fgsvftxv/FlexiTac-2/FlexiTac/Hardware/BOM_FlexiTac_Mini_v1_16x32.xlsx

Sheet: bom模板
 |  |  |  | Bill of Materials | BOM_FlexiTac_Mini_v1_16x32
 |  |  |  | Project Title： | FlexiTac
 |  |  |  | Variant:
 |  |  |  | Report Time： | 2026年7月24日 11:50:50
No. | Quantity | Comment | Designator | Footprint | Value | Manufacturer Part | Manufacturer | Supplier Part | Supplier | LCSC Price | Total
 | 1 | 0R | R1 | R0402 | 0R
 | 1 | 1uF | C7 | C0402 | 1uF
 | 1 | 4.7uF | C8 | C0402 | 4.7uF
 | 1 | 8MHz | X1 | OSC-SMD_3P-L3.2-W1.3-P1.20 | 8MHz | CSTNE8M00G520000R0 | muRata(村田) | C907975 | LCSC | 2.0502
 | 1 | 20R | R7 | R0402 | 20R
 | 1 | 47K | R2 | R0402 | 47K
 | 1 | AT32F415KBU7-4 | U6 | QFN-32_L4.0-W4.0-P0.40-BL-EP2.7 |  | AT32F415KBU7-4 | ARTERY(雅特力) | C528424 | LCSC | 8.42
 | 1 | CD74HC4067SM96 | U2 | SSOP-24_L8.1-W5.3-P0.65-LS7.8-BL |  | CD74HC4067SM96 | TI(德州仪器) | C98457 | LCSC | 3.53
 | 1 | HC-FPC-05-09-16RLTAG | CN1 | CONN-SMD_16P-P0.50_HCTL_HC-FPC-05-09-16RLTAG |  | HC-FPC-05-09-16RLTAG | HCTL(华灿天禄) | C5213753 | LCSC | 1.1019
 | 1 | HC-FPC-05-09-32RLTAG | CN2 | CONN-SMD_32P-P0.50_HCTL_HC-FPC-05-09-32RLTAG |  | HC-FPC-05-09-32RLTAG | HCTL(华灿天禄) | C5213761 | LCSC | 1.2977
 | 1 | LP5907MFX-3.3/NOPB | U3 | SOT-23-5_L3.0-W1.7-P0.95-LS2.8-BR |  | LP5907MFX-3.3/NOPB | TI(德州仪器) | C80670 | LCSC | 1.2647
 | 1 | POWER | LED1 | LED0805-R-RD |  | NCD0805R1 | 国星光电 | C84256 | LCSC | 0.082
 | 1 | SI2301 | Q1 | SOT-23-3_L2.9-W1.3-P1.90-LS2.4-BR |  | SI2301 | YONGYUTAI(永裕泰) | C2891731 | LCSC | 0.1185
 | 1 | STATUS | LED2 | LED0805-R-RD |  | NCD0805R1 | 国星光电 | C84256 | LCSC | 0.082
 | 1 | TLV75733PDBVR | U1 | SOT-23-5_L2.9-W1.6-P0.95-LS2.8-BL |  | TLV75733PDBVR | TI(德州仪器) | C485517 | LCSC | 1.1437
 | 1 | TYPE-C 16PIN 2MD(073) | USB1 | USB-C-SMD_TYPE-C-6PIN-2MD-073 |  | TYPE-C 16PIN 2MD(073) | SHOU HAN(首韩) | C2765186 | LCSC | 0.4563
 | 2 | 4.7K | R8, R9 | R0402 | 4.7K
 | 2 | 5.1K | R13, R16 | R0402 | 5.1K
 | 2 | 10K | R3, R4 | R0402 | 10K
 | 2 | 20K | R5, R6 | R0402 | 20K
 | 2 | SS8550 | Q2, Q3 | SOT-23-3_L2.9-W1.3-P1.90-LS2.4-BR |  | SS8550 | R+O(宏嘉诚) | C7420371 | LCSC | 0.0858
 | 2 | WAFER-GH1.25-4PWB | U9, U10 | CONN-SMD_4P-P1.25_XUNPU_WAFER-GH1.25-4PWB |  | WAFER-GH1.25-4PWB | XUNPU(讯普) | C3029379 | LCSC | 0.759
 | 4 | SN74HC595PWR | U4, U5, U7, U8 | TSSOP-16_L5.0-W4.4-P0.65-LS6.4-BL |  | SN74HC595PWR | TI(德州仪器) | C273642 | LCSC | 1.1074
 | 5 | 10uF | C1, C2, C5, C17, C18 | C0402 | 10uF
 | 6 | 2.2R | R11, R12, R14, R15, R17, R18 | R0402 | 2.2R
 | 8 | 100nF | C6, C9, C10, C11, C12, C14, C15, C16 | C0402 | 100nF

Sheet: Field汇总
Project Title | FlexiTac
Borard Title | Reading_Board_16x32
Schematic Title | Schematic1
PCB Title | PCB1
Variant Name
Total Quantity | 51
Report Time | 11:50:50
Report Date | 2026年7月24日
Report Date&Time | 2026年7月24日 11:50:50
File Name | BOM_FlexiTac_Mini_v1_16x32
Filter Option | Add into BOM:no; Convert to PCB:no;
