fgsvftxv/FlexiTac-2/FlexiTac/Hardware/SCH_FlexiTac_Mini_v1_16x32.pdf

10 10 11 11 12 12 13 13 14 14 15 15 16 16

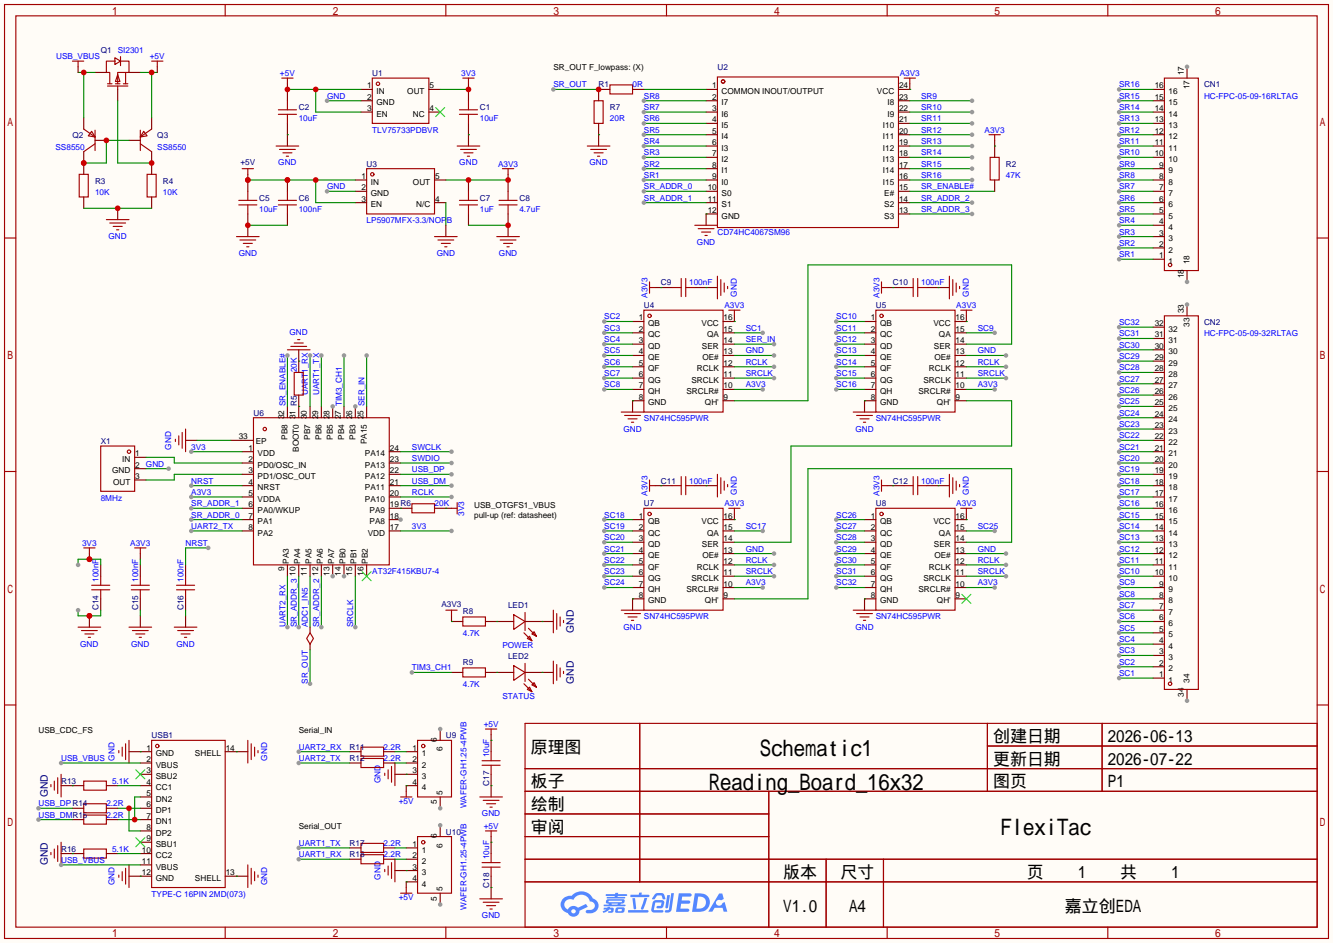
[picture p4: page 1]

SRCLR# 10 SRCLK 11 RCLK 12 OE# 13 SER 14 QA 15 VCC 16

USB_OTGFS1_VBUS
pull-up (ref: datasheet)

原理图 | Schematic1 | 创建日期 | 2026-06-13
板子 | Reading_Board_16x32 | 图页 | P1
绘制 | | FlexiTac
审阅

更新日期 | 2026-07-22

V1.0 | A4 | 嘉立创EDA
