fgsvftxv/FlexiTac-2/FlexiTac/Firmware/FlexiTac_16x32/project/src/main.c

/* add user code begin Header */
/**
  **************************************************************************
  * @file     main.c
  * @brief    main program
  **************************************************************************
  * Copyright (c) 2025, Artery Technology, All rights reserved.
  *
  * The software Board Support Package (BSP) that is made available to
  * download from Artery official website is the copyrighted work of Artery.
  * Artery authorizes customers to use, copy, and distribute the BSP
  * software and its related documentation for the purpose of design and
  * development in conjunction with Artery microcontrollers. Use of the
  * software is governed by this copyright notice and the following disclaimer.
  *
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
  **************************************************************************
  */
/* add user code end Header */

/* Includes ------------------------------------------------------------------*/
#include "at32f415_wk_config.h"
#include "wk_adc.h"
#include "wk_debug.h"
#include "wk_tmr.h"
#include "wk_usart.h"
#include "wk_usb_otgfs.h"
#include "wk_dma.h"
#include "wk_gpio.h"
#include "usb_app.h"
#include "wk_system.h"

/* private includes ----------------------------------------------------------*/
/* add user code begin private includes */
#include "global_include.h"
/* add user code end private includes */

/* private typedef -----------------------------------------------------------*/
/* add user code begin private typedef */

/* add user code end private typedef */

/* private define ------------------------------------------------------------*/
/* add user code begin private define */

/* add user code end private define */

/* private macro -------------------------------------------------------------*/
/* add user code begin private macro */

/* add user code end private macro */

/* private variables ---------------------------------------------------------*/
/* add user code begin private variables */

/* add user code end private variables */

/* private function prototypes --------------------------------------------*/
/* add user code begin function prototypes */

/* add user code end function prototypes */

/* private user code ---------------------------------------------------------*/
/* add user code begin 0 */
#define wk_usb_app_task() ;
#define wk_dma1_channel1_init() ;
#define wk_dma_channel_config(a, b, c, d) ;
#define dma_channel_enable(a, b) ;
#define wk_adc1_init() ;
/* add user code end 0 */

/**
  * @brief main function.
  * @param  none
  * @retval none
  */
int main(void)
{
  /* add user code begin 1 */

  /* add user code end 1 */

  /* system clock config. */
  wk_system_clock_config();

  /* config periph clock. */
  wk_periph_clock_config();

  /* init debug function. */
  wk_debug_config();

  /**
   * users need add interrupt handler code into the below function in the at32f415_int.c file.
   *  --void SystTick_IRQHandler(void)
   */
  systick_interrupt_config(1000);

  /* nvic config. */
  wk_nvic_config();

  /* timebase config for
     void wk_delay_us(uint32_t delay);
     void wk_delay_ms(uint32_t delay); */
  wk_timebase_init();

  /* init gpio function. */
  wk_gpio_config();

  /* init adc1 function. */
  wk_adc1_init();

  /* init usart1 function. */
  wk_usart1_init();

  /* init usart2 function. */
  wk_usart2_init();

  /* init tmr3 function. */
  wk_tmr3_init();

  /* init usb_otgfs1 function. */
  wk_usb_otgfs1_init();

  /* init usb app function. */
  wk_usb_app_init();

  /* init dma1 channel1 */
  wk_dma1_channel1_init();
  /* config dma channel transfer parameter */
  /* user need to modify define values DMAx_CHANNELy_XXX_BASE_ADDR 
     and DMAx_CHANNELy_BUFFER_SIZE in at32xxx_wk_config.h */
  wk_dma_channel_config(DMA1_CHANNEL1, 
                        (uint32_t)&USART1->dt, 
                        DMA1_CHANNEL1_MEMORY_BASE_ADDR, 
                        DMA1_CHANNEL1_BUFFER_SIZE);
  dma_channel_enable(DMA1_CHANNEL1, TRUE);

  /* init dma1 channel2 */
  wk_dma1_channel2_init();
  /* config dma channel transfer parameter */
  /* user need to modify define values DMAx_CHANNELy_XXX_BASE_ADDR 
     and DMAx_CHANNELy_BUFFER_SIZE in at32xxx_wk_config.h */
  wk_dma_channel_config(DMA1_CHANNEL2, 
                        (uint32_t)&USART1->dt, 
                        DMA1_CHANNEL2_MEMORY_BASE_ADDR, 
                        DMA1_CHANNEL2_BUFFER_SIZE);
  dma_channel_enable(DMA1_CHANNEL2, TRUE);

  /* init dma1 channel3 */
  wk_dma1_channel3_init();
  /* config dma channel transfer parameter */
  /* user need to modify define values DMAx_CHANNELy_XXX_BASE_ADDR 
     and DMAx_CHANNELy_BUFFER_SIZE in at32xxx_wk_config.h */
  wk_dma_channel_config(DMA1_CHANNEL3, 
                        (uint32_t)&USART2->dt, 
                        DMA1_CHANNEL3_MEMORY_BASE_ADDR, 
                        DMA1_CHANNEL3_BUFFER_SIZE);
  dma_channel_enable(DMA1_CHANNEL3, TRUE);

  /* init dma1 channel4 */
  wk_dma1_channel4_init();
  /* config dma channel transfer parameter */
  /* user need to modify define values DMAx_CHANNELy_XXX_BASE_ADDR 
     and DMAx_CHANNELy_BUFFER_SIZE in at32xxx_wk_config.h */
  wk_dma_channel_config(DMA1_CHANNEL4, 
                        (uint32_t)&USART2->dt, 
                        DMA1_CHANNEL4_MEMORY_BASE_ADDR, 
                        DMA1_CHANNEL4_BUFFER_SIZE);
  dma_channel_enable(DMA1_CHANNEL4, TRUE);

  /* add user code begin 2 */
  app_init();
  /* add user code end 2 */

  while(1)
  {
    wk_usb_app_task();

    /* add user code begin 3 */
    app_loop();
    /* add user code end 3 */
  }
}

  /* add user code begin 4 */

  /* add user code end 4 */
