fgsvftxv/FlexiTac-2/FlexiTac/Firmware/FlexiTac_16x32/project/inc/at32f415_wk_config.h

/* add user code begin Header */
/**
  **************************************************************************
  * @file     at32f415_wk_config.h
  * @brief    header file of work bench config
  **************************************************************************
  * Copyright (c) 2025, Artery Technology, All rights reserved.
  *
  * The software Board Support Package (BSP) that is made available to
  * download from Artery official website is the copyrighted work of Artery.
  * Artery authorizes customers to use, copy, and distribute the BSP
  * software and its related documentation for the purpose of design and
  * development in conjunction with Artery microcontrollers. Use of the
  * software is governed by this copyright notice and the following disclaimer.
  *
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
  **************************************************************************
  */
/* add user code end Header */

/* define to prevent recursive inclusion -----------------------------------*/
#ifndef __AT32F415_WK_CONFIG_H
#define __AT32F415_WK_CONFIG_H

#ifdef __cplusplus
extern "C" {
#endif

/* includes -----------------------------------------------------------------------*/
#include "stdio.h"
#include "at32f415.h"

/* private includes -------------------------------------------------------------*/
/* add user code begin private includes */

/* add user code end private includes */

/* exported types -------------------------------------------------------------*/
/* add user code begin exported types */

/* add user code end exported types */

/* exported constants --------------------------------------------------------*/
/* add user code begin exported constants */

/* add user code end exported constants */

/* exported macro ------------------------------------------------------------*/
/* add user code begin exported macro */

/* add user code end exported macro */

/* add user code begin dma define */
/* user can only modify the dma define value */
#define DMA1_CHANNEL1_BUFFER_SIZE   0
#define DMA1_CHANNEL1_MEMORY_BASE_ADDR   0
//#define DMA1_CHANNEL1_PERIPHERAL_BASE_ADDR  0

#define DMA1_CHANNEL2_BUFFER_SIZE   0
#define DMA1_CHANNEL2_MEMORY_BASE_ADDR   0
//#define DMA1_CHANNEL2_PERIPHERAL_BASE_ADDR   0

#define DMA1_CHANNEL3_BUFFER_SIZE   0
#define DMA1_CHANNEL3_MEMORY_BASE_ADDR   0
//#define DMA1_CHANNEL3_PERIPHERAL_BASE_ADDR   0

#define DMA1_CHANNEL4_BUFFER_SIZE   0
#define DMA1_CHANNEL4_MEMORY_BASE_ADDR   0
//#define DMA1_CHANNEL4_PERIPHERAL_BASE_ADDR   0

//#define DMA1_CHANNEL5_BUFFER_SIZE   0
//#define DMA1_CHANNEL5_MEMORY_BASE_ADDR   0
//#define DMA1_CHANNEL5_PERIPHERAL_BASE_ADDR   0

//#define DMA1_CHANNEL6_BUFFER_SIZE   0
//#define DMA1_CHANNEL6_MEMORY_BASE_ADDR   0
//#define DMA1_CHANNEL6_PERIPHERAL_BASE_ADDR   0

//#define DMA1_CHANNEL7_BUFFER_SIZE   0
//#define DMA1_CHANNEL7_MEMORY_BASE_ADDR   0
//#define DMA1_CHANNEL7_PERIPHERAL_BASE_ADDR   0

//#define DMA2_CHANNEL1_BUFFER_SIZE   0
//#define DMA2_CHANNEL1_MEMORY_BASE_ADDR   0
//#define DMA2_CHANNEL1_PERIPHERAL_BASE_ADDR   0

//#define DMA2_CHANNEL2_BUFFER_SIZE   0
//#define DMA2_CHANNEL2_MEMORY_BASE_ADDR   0
//#define DMA2_CHANNEL2_PERIPHERAL_BASE_ADDR   0

//#define DMA2_CHANNEL3_BUFFER_SIZE   0
//#define DMA2_CHANNEL3_MEMORY_BASE_ADDR   0
//#define DMA2_CHANNEL3_PERIPHERAL_BASE_ADDR   0

//#define DMA2_CHANNEL4_BUFFER_SIZE   0
//#define DMA2_CHANNEL4_MEMORY_BASE_ADDR   0
//#define DMA2_CHANNEL4_PERIPHERAL_BASE_ADDR   0

//#define DMA2_CHANNEL5_BUFFER_SIZE   0
//#define DMA2_CHANNEL5_MEMORY_BASE_ADDR   0
//#define DMA2_CHANNEL5_PERIPHERAL_BASE_ADDR   0

//#define DMA2_CHANNEL6_BUFFER_SIZE   0
//#define DMA2_CHANNEL6_MEMORY_BASE_ADDR   0
//#define DMA2_CHANNEL6_PERIPHERAL_BASE_ADDR   0

//#define DMA2_CHANNEL7_BUFFER_SIZE   0
//#define DMA2_CHANNEL7_MEMORY_BASE_ADDR   0
//#define DMA2_CHANNEL7_PERIPHERAL_BASE_ADDR   0
/* add user code end dma define */

/* Private defines -------------------------------------------------------------*/
#define SR_ADDR_1_PIN    GPIO_PINS_0
#define SR_ADDR_1_GPIO_PORT    GPIOA
#define SR_ADDR_0_PIN    GPIO_PINS_1
#define SR_ADDR_0_GPIO_PORT    GPIOA
#define SR_ADDR_3_PIN    GPIO_PINS_4
#define SR_ADDR_3_GPIO_PORT    GPIOA
#define SR_ADDR_2_PIN    GPIO_PINS_6
#define SR_ADDR_2_GPIO_PORT    GPIOA
#define SRCLK_PIN    GPIO_PINS_1
#define SRCLK_GPIO_PORT    GPIOB
#define RCLK_PIN    GPIO_PINS_10
#define RCLK_GPIO_PORT    GPIOA
#define SER_IN_PIN    GPIO_PINS_15
#define SER_IN_GPIO_PORT    GPIOA
#define SR_ENABLE_PIN    GPIO_PINS_8
#define SR_ENABLE_GPIO_PORT    GPIOB

/* exported functions ------------------------------------------------------- */
  /* system clock config. */
  void wk_system_clock_config(void);

  /* config periph clock. */
  void wk_periph_clock_config(void);

  /* nvic config. */
  void wk_nvic_config(void);

/* add user code begin exported functions */

/* add user code end exported functions */

#ifdef __cplusplus
}
#endif

#endif
