fgsvftxv/FlexiTac-2/FlexiTac/Firmware/FlexiTac_16x32/User/Apps/flexitac_packet.c

#include "flexitac_packet.h"

#include <string.h>

uint32_t get_serial_number(void)
{
#if defined(AT32F403Axx) || defined(AT32F407xx) || defined(AT32F435xx) || defined(AT32F415KBU7_4)
#define FLASH_SIZE_BASE 0x1FFFF7E0
#define UID_BASE_1      0x1FFFF7E8
#define UID_BASE_2      0x1FFFF7EC
#define UID_BASE_3      0x1FFFF7F0
    const uint8_t *p = (const uint8_t *)UID_BASE_1;
    return ((uint32_t)p[10]<<24) | ((uint32_t)p[1]<<8) | p[0]
        | (((p[9]&0x80)|((p[4]&0x03)<<5)|((p[3]&0xF0)>>3)|(p[2]&0x01))<<16);
#else
#warning "_get_sn() unavailable for unknown chip"
#endif
}

static uint8_t crc16_table_h[256] =
    {
            0x00, 0xC1, 0x81, 0x40, 0x01, 0xC0, 0x80, 0x41, 0x01, 0xC0, 0x80, 0x41,
            0x00, 0xC1, 0x81, 0x40, 0x01, 0xC0, 0x80, 0x41, 0x00, 0xC1, 0x81, 0x40,
            0x00, 0xC1, 0x81, 0x40, 0x01, 0xC0, 0x80, 0x41, 0x01, 0xC0, 0x80, 0x41,
            0x00, 0xC1, 0x81, 0x40, 0x00, 0xC1, 0x81, 0x40, 0x01, 0xC0, 0x80, 0x41,
            0x00, 0xC1, 0x81, 0x40, 0x01, 0xC0, 0x80, 0x41, 0x01, 0xC0, 0x80, 0x41,
            0x00, 0xC1, 0x81, 0x40, 0x01, 0xC0, 0x80, 0x41, 0x00, 0xC1, 0x81, 0x40,
            0x00, 0xC1, 0x81, 0x40, 0x01, 0xC0, 0x80, 0x41, 0x00, 0xC1, 0x81, 0x40,
            0x01, 0xC0, 0x80, 0x41, 0x01, 0xC0, 0x80, 0x41, 0x00, 0xC1, 0x81, 0x40,
            0x00, 0xC1, 0x81, 0x40, 0x01, 0xC0, 0x80, 0x41, 0x01, 0xC0, 0x80, 0x41,
            0x00, 0xC1, 0x81, 0x40, 0x01, 0xC0, 0x80, 0x41, 0x00, 0xC1, 0x81, 0x40,
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
/// Initial Value: 0xFFFF, Input Flip: Yes, Output Flip: No \n
/// XOR Value: 0x0000
/// \param data
/// \param len
/// \return
uint16_t get_crc16(const uint8_t* data, const size_t len)
{
    return get_crc16_accumulate(0xFFFF, data, len);
}

uint32_t serial_number = 0;
uint32_t tick_ms = 0;

uint8_t build_flexitac_packet(uint8_t* dst_buffer, uint16_t* dst_buffer_in_out_size, const uint16_t* sample_data, const uint16_t sample_count)
{
    if(!dst_buffer || !dst_buffer_in_out_size || !sample_data || *dst_buffer_in_out_size < sizeof(flexitac_packet_t)) return 0;
    flexitac_packet_t* packet = (flexitac_packet_t*)dst_buffer;
    if(sample_count != FLEXITAC_SAMPLE_COUNT) return 0;
    packet->ext_header_0x54 = 0x54;
    packet->ext_header_0xaa = 0xAA;
    if(!serial_number) serial_number = get_serial_number();
    packet->node_uuid_u16[0] = (uint8_t)(serial_number & 0xFF);
    packet->node_uuid_u16[1] = (uint8_t)(serial_number >> 8);
    packet->node_timestamp[0] = (uint8_t)(tick_ms & 0xFF);
    packet->node_timestamp[1] = (uint8_t)(tick_ms >> 8);
    packet->node_timestamp[2] = (uint8_t)(tick_ms >> 16);
    packet->node_timestamp[3] = (uint8_t)(tick_ms >> 24);
    packet->data_size[0] = (uint8_t)(FLEXITAC_DATA_BYTES & 0xFF);
    packet->data_size[1] = (uint8_t)(FLEXITAC_DATA_BYTES >> 8);
    packet->data_header_0xaa = 0xAA;
    packet->data_header_0x55 = 0x55;
    for(uint16_t i = 0; i < sample_count; i++)
    {
        packet->data[2u * i] = (uint8_t)(sample_data[i] & 0xFFu);
        packet->data[2u * i + 1u] = (uint8_t)(sample_data[i] >> 8);
    }
    const uint16_t crc16 = get_crc16((const uint8_t*)packet, sizeof(flexitac_packet_t) - 2);
    packet->crc16[0] = (uint8_t)(crc16 & 0xFF);
    packet->crc16[1] = (uint8_t)(crc16 >> 8);
    *dst_buffer_in_out_size = sizeof(flexitac_packet_t);
    return 1;
}
